HashooSashoo/ELEC_327_FinalProject/docs/pictures/first_ever_color_test_on_screen.jpeg

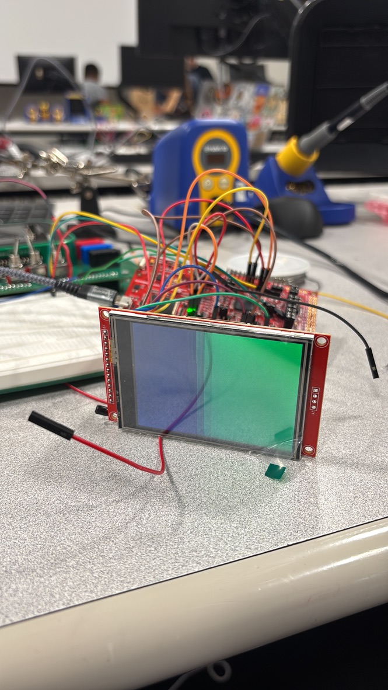
docs/pictures/first_ever_color_test_on_screen.jpeg
