HashooSashoo/ELEC_327_FinalProject/docs/pictures/a_melted_joystick_from_trying_to_desolder.jpeg

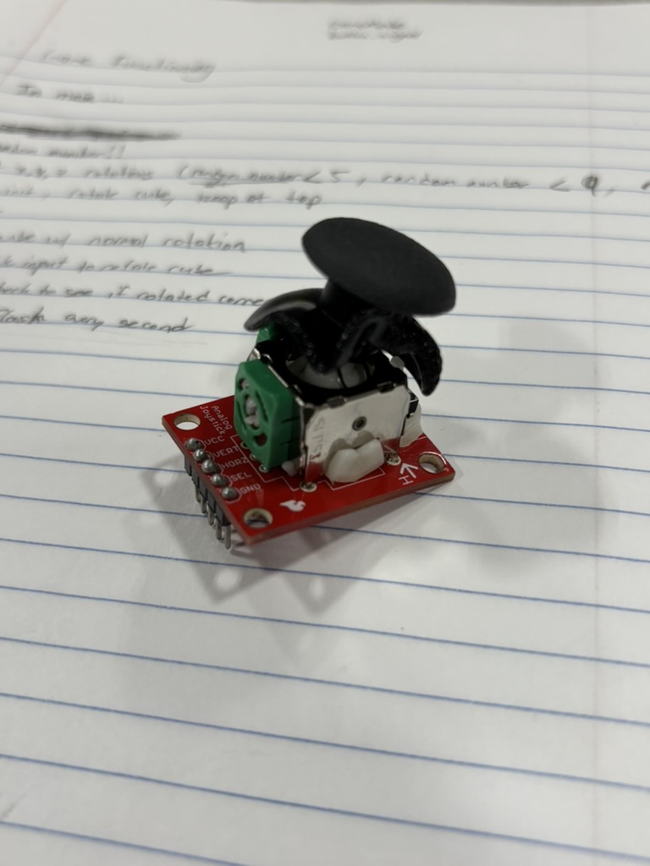
docs/pictures/a_melted_joystick_from_trying_to_desolder.jpeg
