HashooSashoo/ELEC_327_FinalProject/docs/pictures/breakout_board_after_first_smoked_and_died.jpeg

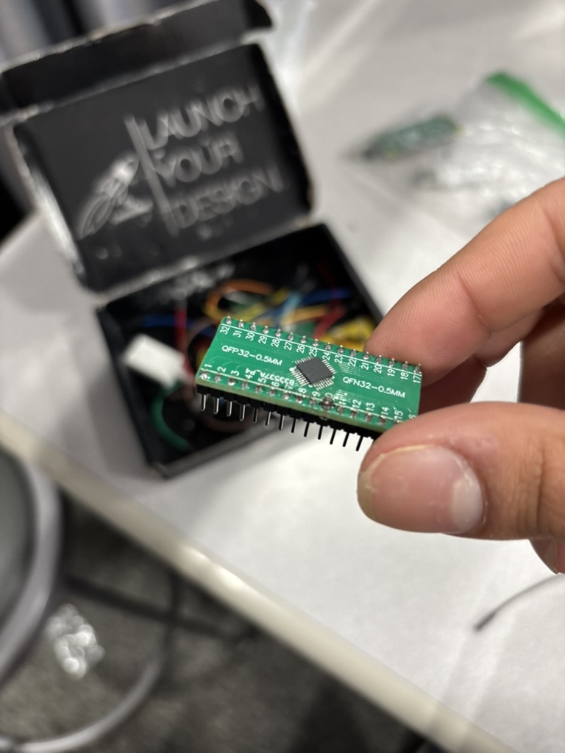
docs/pictures/breakout_board_after_first_smoked_and_died.jpeg
