HashooSashoo/ELEC_327_FinalProject/docs/pictures/facetime_when_final_product_was_working.png

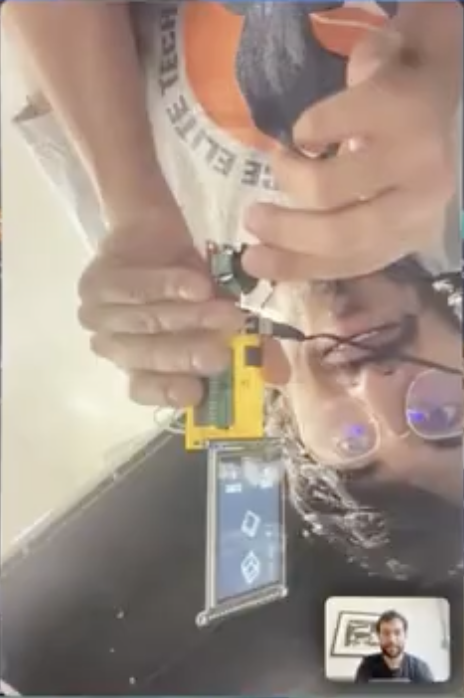
docs/pictures/facetime_when_final_product_was_working.png
