HashooSashoo/ELEC_327_FinalProject/docs/pictures/first_iteration_of_final_screen.jpeg

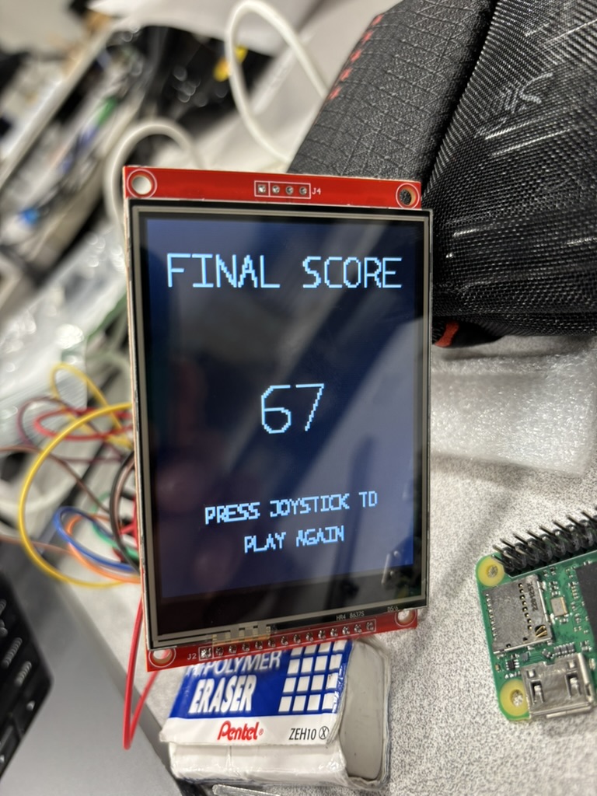
docs/pictures/first_iteration_of_final_screen.jpeg
