HashooSashoo/ELEC_327_FinalProject/docs/pictures/first_pcb_draft_completely_wrong.jpeg

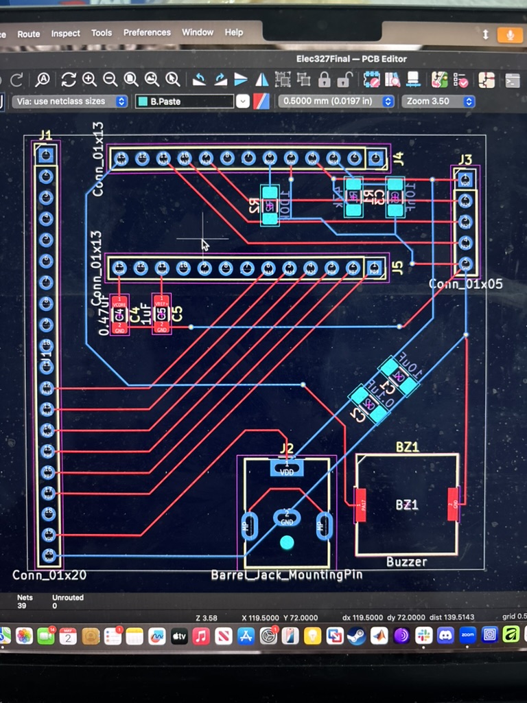
docs/pictures/first_pcb_draft_completely_wrong.jpeg
