HashooSashoo/ELEC_327_FinalProject/docs/pictures/linkedin_pictures/kasims_linkedin.jpeg

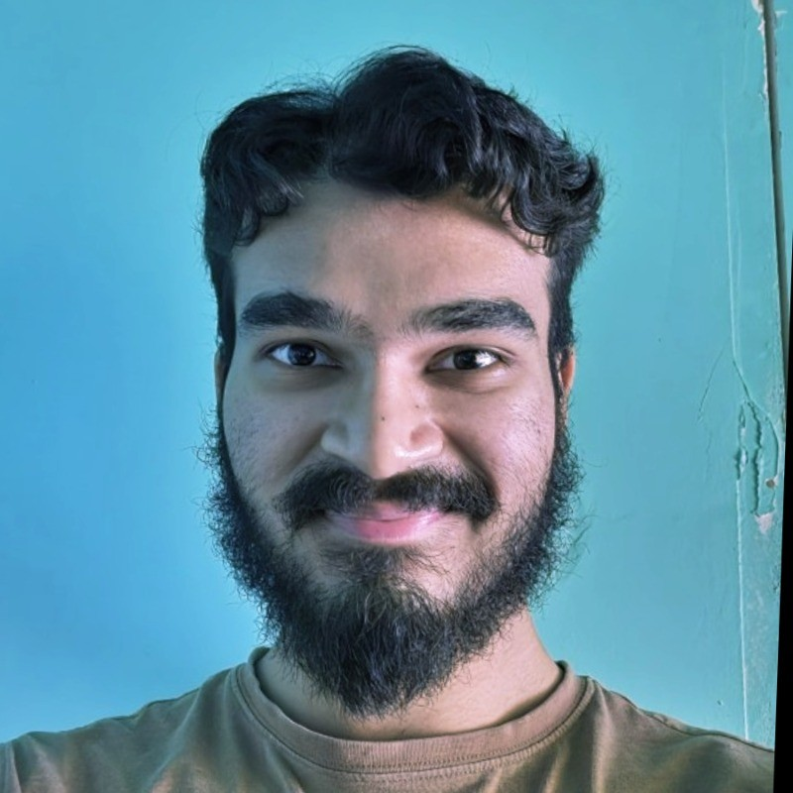
docs/pictures/linkedin_pictures/kasims_linkedin.jpeg
