HashooSashoo/ELEC_327_FinalProject/docs/pictures/linkedin_pictures/milans_linkedin.jpeg

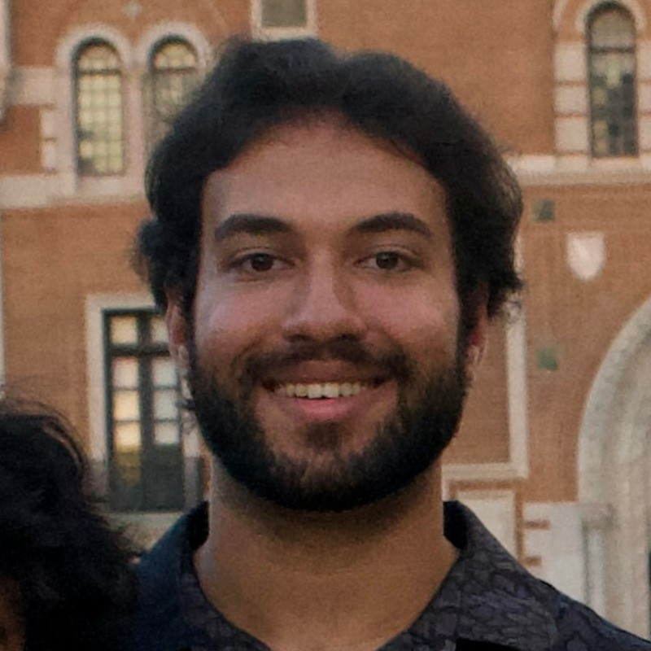
docs/pictures/linkedin_pictures/milans_linkedin.jpeg
