HashooSashoo/ELEC_327_FinalProject/docs/pictures/linkedin_pictures/nathans_linkedin.jpeg

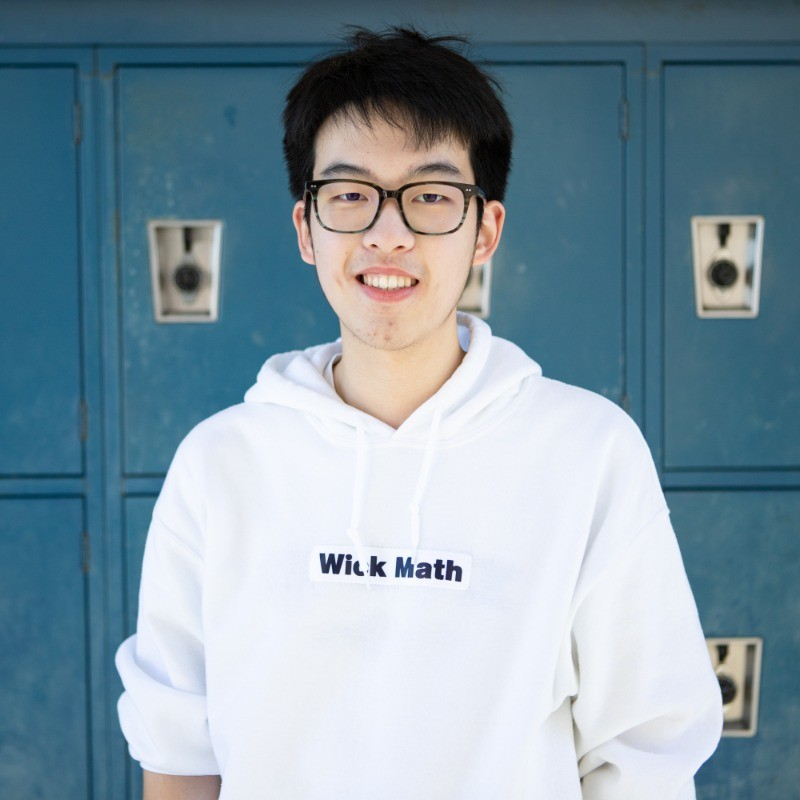
docs/pictures/linkedin_pictures/nathans_linkedin.jpeg
