HashooSashoo/ELEC_327_FinalProject/docs/pictures/linkedin_pictures/zaks_linkedin.jpeg

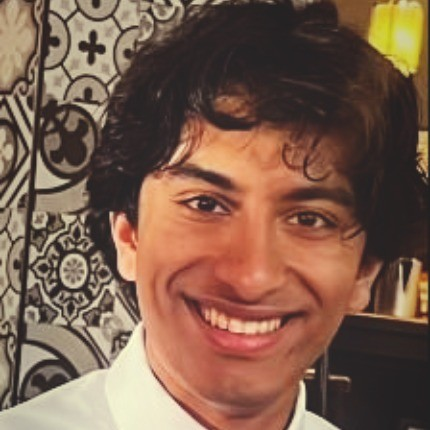
docs/pictures/linkedin_pictures/zaks_linkedin.jpeg
