HashooSashoo/ELEC_327_FinalProject/docs/pictures/checkerboard_test_on_screen.jpeg

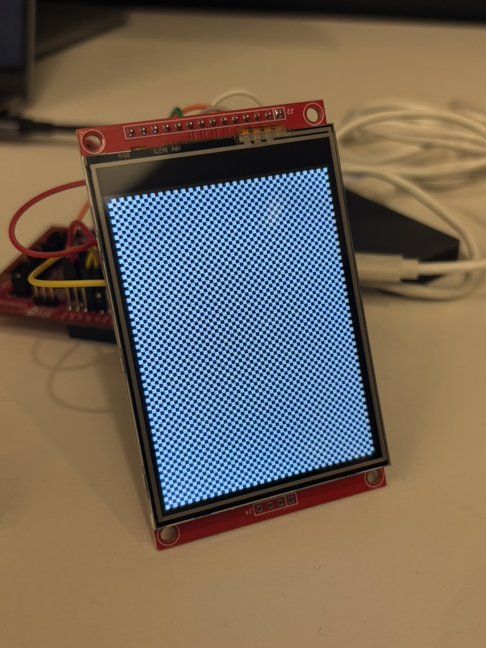
docs/pictures/checkerboard_test_on_screen.jpeg
