HashooSashoo/ELEC_327_FinalProject/docs/pictures/our_first_cube_test.jpeg

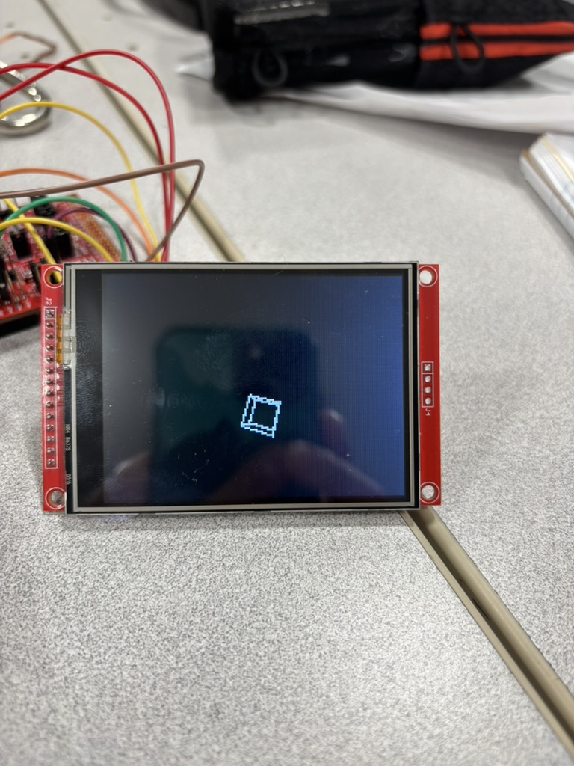
docs/pictures/our_first_cube_test.jpeg
