HashooSashoo/ELEC_327_FinalProject/docs/pictures/square_test_on_screen.jpeg

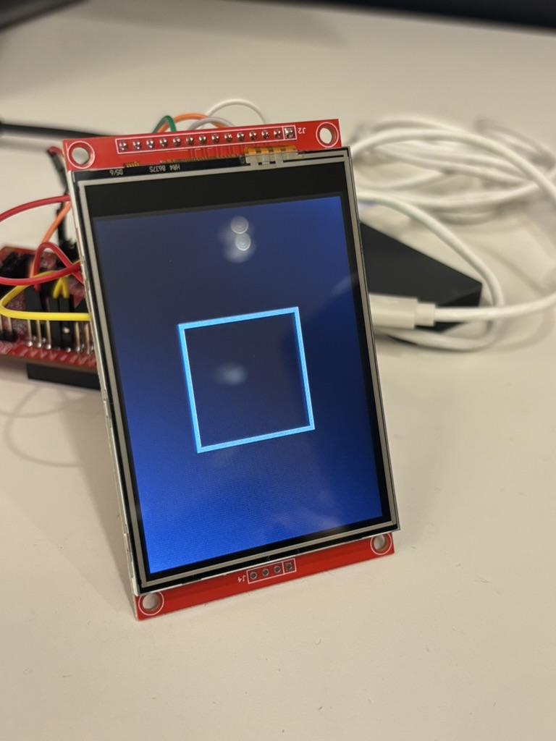
docs/pictures/square_test_on_screen.jpeg
