HashooSashoo/ELEC_327_FinalProject/pcb/Elec327Final.kicad_pcb

## KiCad design pcb/Elec327Final.kicad_pcb (2026-05-16)

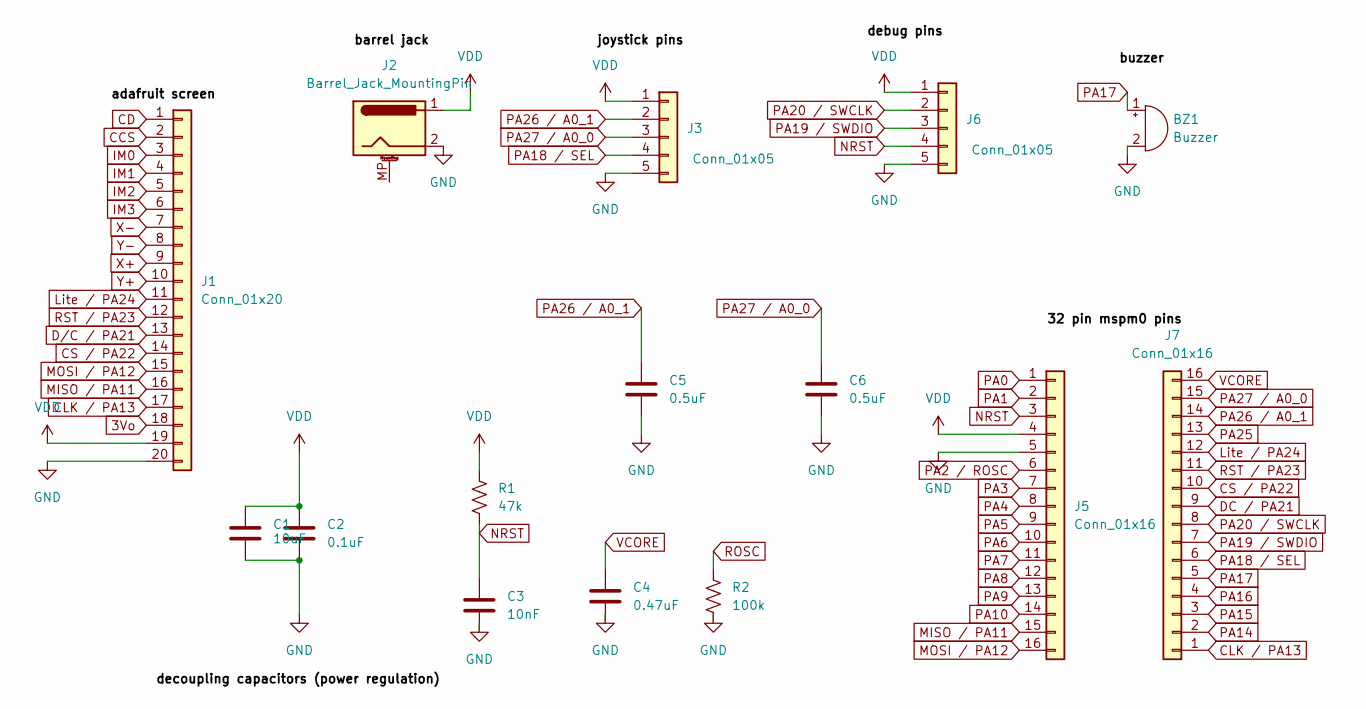
[picture p18: schematic Elec327Final.kicad_sch]

Parts:
BZ1: Buzzer; Buzzer_Murata_PKLCS1212E
C1: 10uF; C_1206_3216Metric_Pad1.33x1.80mm_HandSolder
C2: 0.1uF; C_1206_3216Metric_Pad1.33x1.80mm_HandSolder
C3: 10nF; C_1206_3216Metric_Pad1.33x1.80mm_HandSolder
C4: 0.47uF; C_1206_3216Metric_Pad1.33x1.80mm_HandSolder
C5, C6: 0.5uF; C_1206_3216Metric_Pad1.33x1.80mm_HandSolder
J1: Conn_01x20; PinHeader_1x20_P2.54mm_Vertical
J2: Barrel_Jack_MountingPin; BarrelJack_CUI_PJ-063AH_Horizontal
J3, J6: Conn_01x05; PinHeader_1x05_P2.54mm_Vertical
J5, J7: Conn_01x16; PinHeader_1x16_P2.54mm_Vertical
R1: 47k; R_1206_3216Metric_Pad1.30x1.75mm_HandSolder
R2: 100k; R_1206_3216Metric_Pad1.30x1.75mm_HandSolder

Connections:
3Vo: J1.18
CCS: J1.2
CD: J1.1
CLK / PA13: J1.17, J7.1
CS / PA22: J1.14, J7.10
DC / PA21: J7.9
D/C / PA21: J1.13
GND: BZ1.2 (-), C1.2, C2.2, C3.2, C4.2, C5.2, C6.2, J1.20, J2.2, J3.5, J5.5, J6.5, R2.2
IM0: J1.3
IM1: J1.4
IM2: J1.5
IM3: J1.6
Lite / PA24: J1.11, J7.12
MISO / PA11: J1.16, J5.15
MOSI / PA12: J1.15, J5.16
NRST: C3.1, J5.3, J6.4, R1.2
PA0: J5.1
PA1: J5.2
PA2 / ROSC: J5.6
PA3: J5.7
PA4: J5.8
PA5: J5.9
PA6: J5.10
PA7: J5.11
PA8: J5.12
PA9: J5.13
PA10: J5.14
PA14: J7.2
PA15: J7.3
PA16: J7.4
PA17: BZ1.1 (+), J7.5
PA18 / SEL: J3.4, J7.6
PA19 / SWDIO: J6.3, J7.7
PA20 / SWCLK: J6.2, J7.8
PA25: J7.13
PA26 / A0_1: C5.1, J3.2, J7.14
PA27 / A0_0: C6.1, J3.3, J7.15
ROSC: R2.1
RST / PA23: J1.12, J7.11
VCORE: C4.1, J7.16
VDD: C1.1, C2.1, J1.19, J2.1, J3.1, J5.4, J6.1, R1.1
X+: J1.9
X-: J1.7
Y+: J1.10
Y-: J1.8

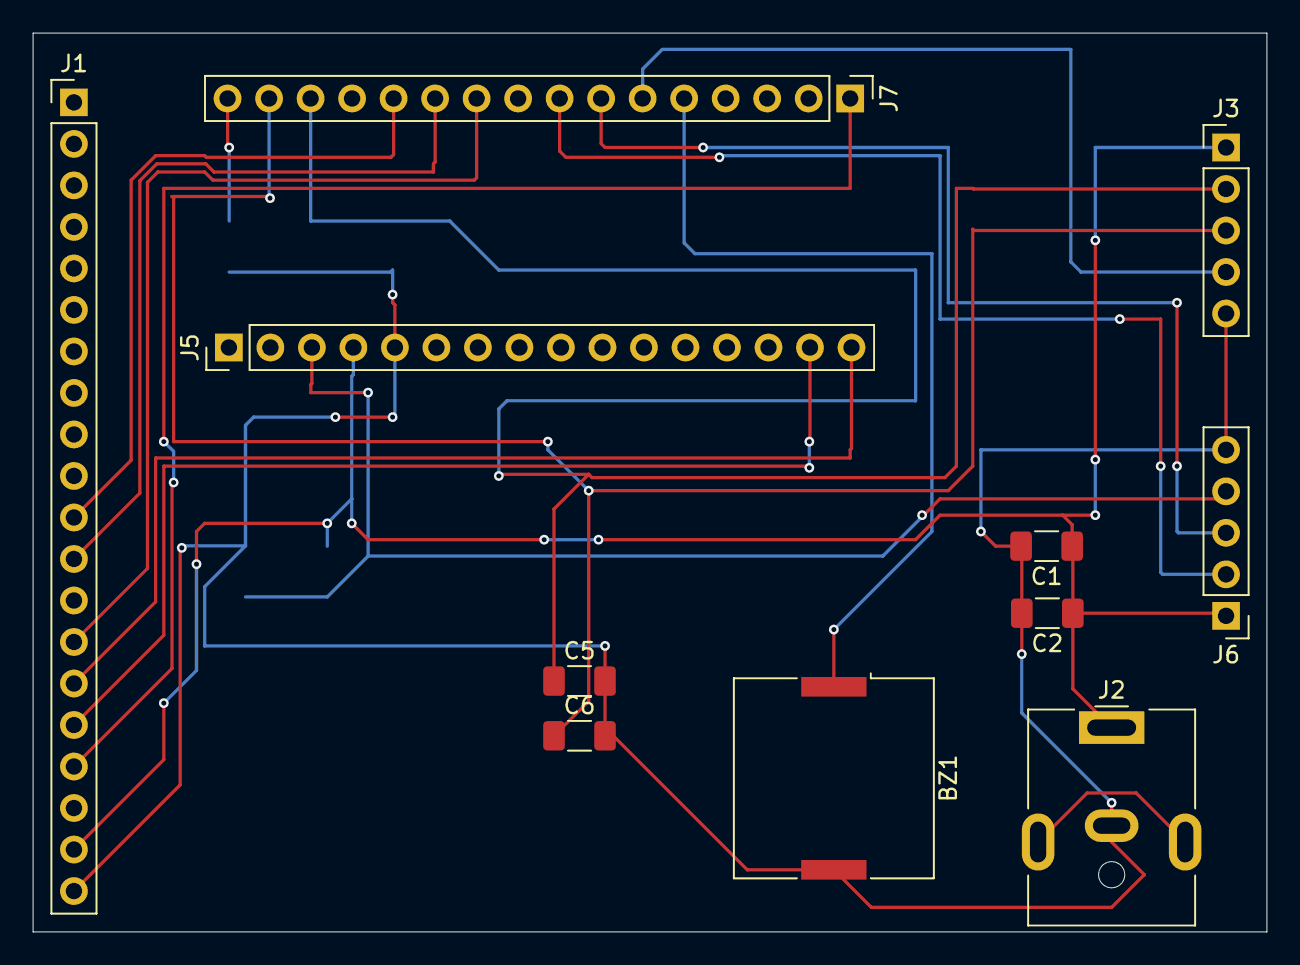
[picture p19: board Elec327Final.kicad_pcb from above]

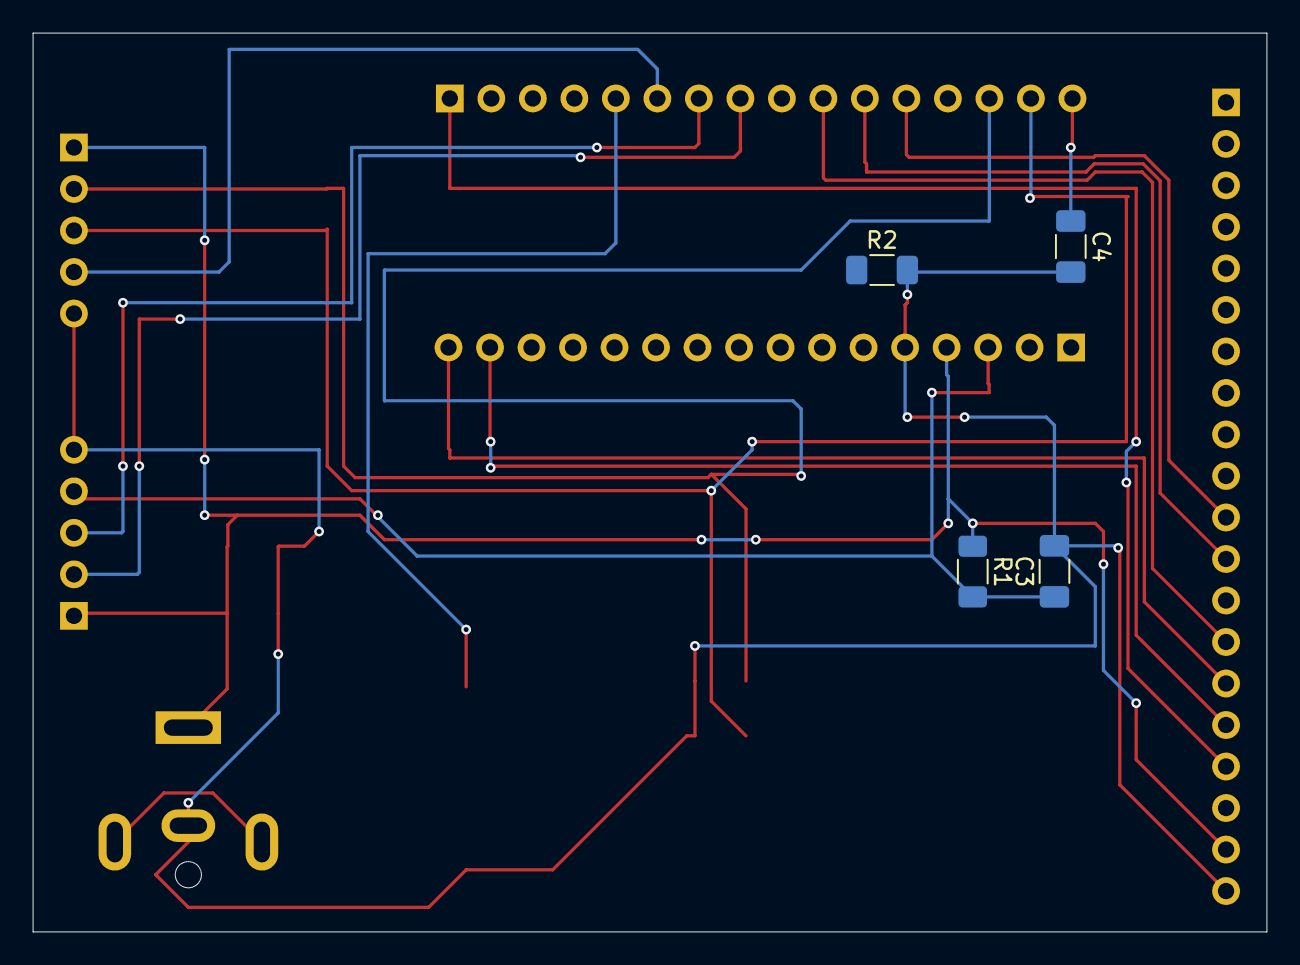
[picture p20: board Elec327Final.kicad_pcb from below]

Board: 2 copper layers, 75.5 x 55.0 mm, 15 parts (4 on the bottom side), 16 nets.
