HashooSashoo/ELEC_327_FinalProject/code/delay.h

#ifndef delay_include
#define delay_include

#include <stdint.h>


#define POWER_STARTUP_DELAY (16)
#define MS_TO_CYCLES(ms) ((uint32_t)(ms) * 32000)

/**
 * @brief   Consumes the number of CPU cycles specified.
 *
 * @param[in] cycles  Floor number of cycles to delay.
 *                    Specifying zero will result in the maximum
 *                    possible delay. Note that guarantees at least
 *                    this number of cycles will be delayed,
 *                    not that exactly this number of cycles will be
 *                    delayed. If a more precise number of cycle delay value
 *                    is needed, GPTimer is recommended.
 *
 *                    Typical variance from this function is 10 cycles or
 *                    less assuming that the function is located in flash and
 *                    that caching is enabled. Disabling caching may result in
 *                    wait-states when fetching from flash.
 *                    Other variance occurs due:
 *                      - Amount of register stacking/unstacking around API entry/exit
 *                      - Value of cycles relative to 4-cycle loop counter
 *                      - Placement of code on a 2- or 4-byte aligned boundary
 */
void delay_cycles(uint32_t cycles);



#endif // delay_include




/*
 *
 * The delay function is a reproduction of standard TI code
 * Copyright (c) 2020, Texas Instruments Incorporated
 * All rights reserved.
 *
 * All other code is Copyright (c) 2026, Caleb Kemere
 * All rights reserved, see LICENSE.md

 *
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
 * *  Redistributions of source code must retain the above copyright
 *    notice, this list of conditions and the following disclaimer.
 *
 * *  Redistributions in binary form must reproduce the above copyright
 *    notice, this list of conditions and the following disclaimer in the
 *    documentation and/or other materials provided with the distribution.
 *
 * *  Neither the name of Texas Instruments Incorporated nor the names of
 *    its contributors may be used to endorse or promote products derived
 *    from this software without specific prior written permission.
 *
 * THIS SOFTWARE IS PROVIDED BY THE COPYRIGHT HOLDERS AND CONTRIBUTORS "AS IS"
 * AND ANY EXPRESS OR IMPLIED WARRANTIES, INCLUDING, BUT NOT LIMITED TO,
 * THE IMPLIED WARRANTIES OF MERCHANTABILITY AND FITNESS FOR A PARTICULAR
 * PURPOSE ARE DISCLAIMED. IN NO EVENT SHALL THE COPYRIGHT OWNER OR
 * CONTRIBUTORS BE LIABLE FOR ANY DIRECT, INDIRECT, INCIDENTAL, SPECIAL,
 * EXEMPLARY, OR CONSEQUENTIAL DAMAGES (INCLUDING, BUT NOT LIMITED TO,
 * PROCUREMENT OF SUBSTITUTE GOODS OR SERVICES; LOSS OF USE, DATA, OR PROFITS;
 * OR BUSINESS INTERRUPTION) HOWEVER CAUSED AND ON ANY THEORY OF LIABILITY,
 * WHETHER IN CONTRACT, STRICT LIABILITY, OR TORT (INCLUDING NEGLIGENCE OR
 * OTHERWISE) ARISING IN ANY WAY OUT OF THE USE OF THIS SOFTWARE,
 * EVEN IF ADVISED OF THE POSSIBILITY OF SUCH DAMAGE.
 *
 */
