HashooSashoo/ELEC_327_FinalProject/(commit log)

2026-04-20 initial commit, contains SPI and GPIO initialization code, commands for LCD screen, and a function to maek background color
2026-04-21 feat: peripheral init (ADC,TIMG2,TIMA0,NVM)
2026-04-23 added functions to get horizontal, vertical ADC values
2026-04-24 finalized pin assignments for buzzer and button
2026-05-16 LOTS of changes, reorganized files, added initial draft of website, pcb files, col pictures, etc.
    [Elec327Final.kicad_pcb, Elec327Final.kicad_sch]
